kgutwin/teensy-audio-meter/docs/Compact Zoom VU Meter - Display v9.pdf

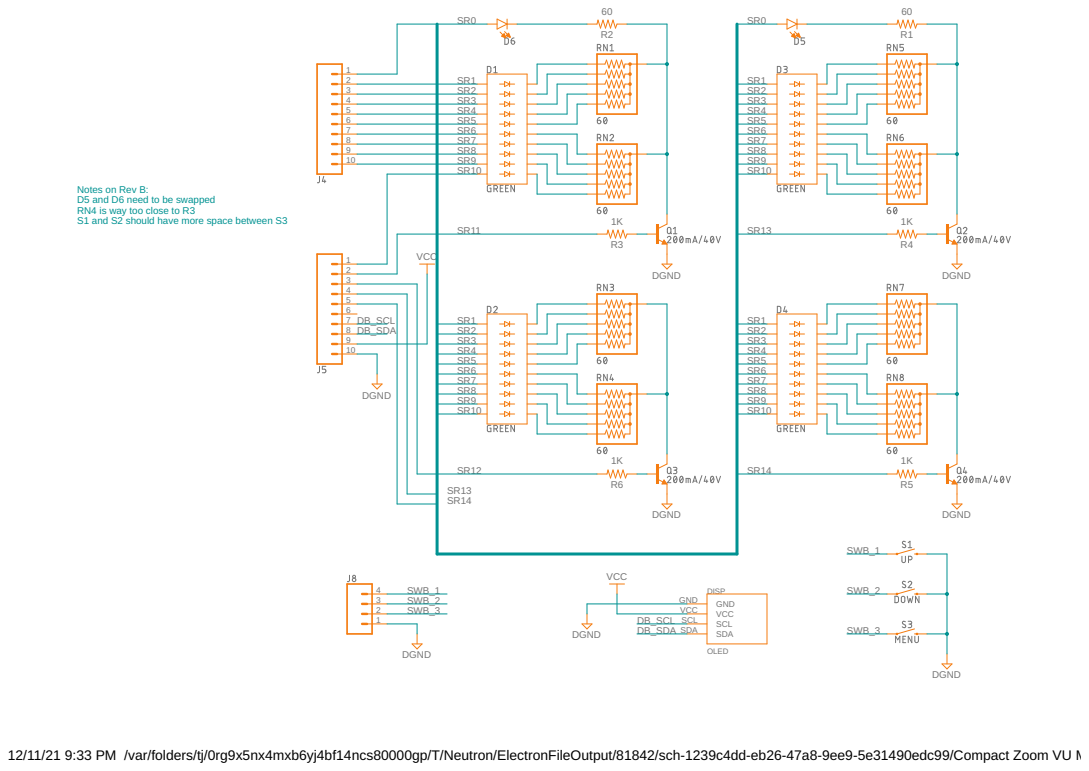
[picture p1: page 1]

Notes on Rev B: D5 and D6 need to be swapped
RN4 is way too close to R3
S1 and S2 should have more space between S3

12/11/21 9:33 PM /var/folders/tj/0rg9x5nx4mxb6yj4bf14ncs80000gp/T/Neutron/ElectronFileOutput/81842/sch-1239c4dd-eb26-47a8-9ee9-5e31490edc99/Compact Zoom VU Meter - Display v9.sch (Sheet: 1/1)
