kgutwin/teensy-audio-meter/docs/Compact Zoom VU Meter - Main v3.pdf

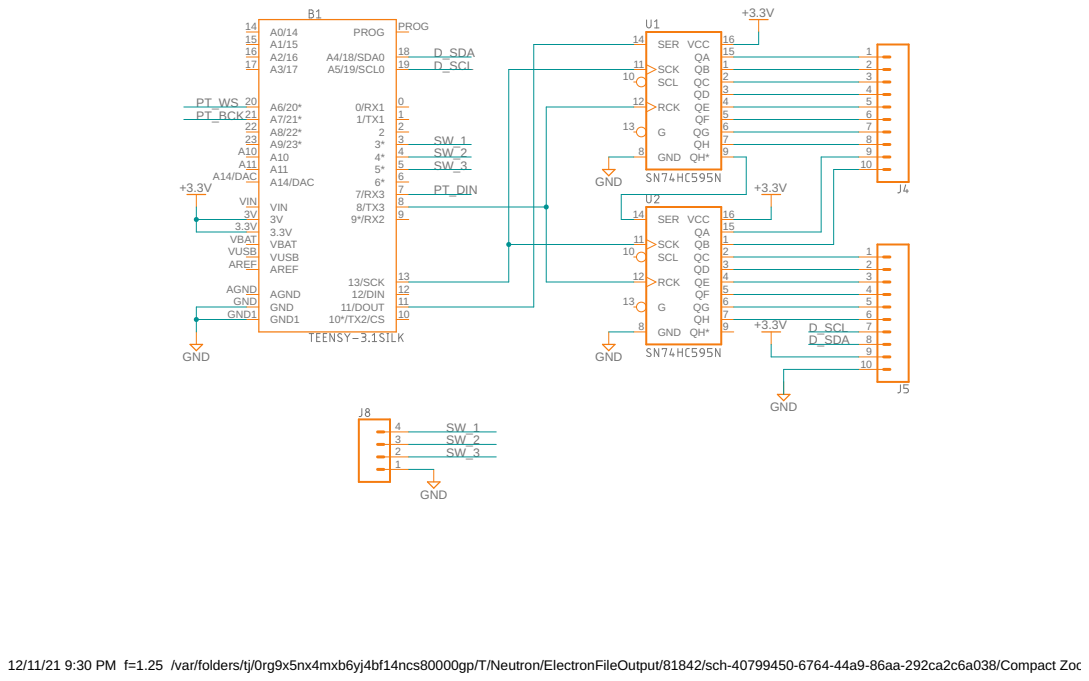
[picture p2: page 1]

12/11/21 9:30 PM f=1.25 /var/folders/tj/0rg9x5nx4mxb6yj4bf14ncs80000gp/T/Neutron/ElectronFileOutput/81842/sch-40799450-6764-44a9-86aa-292ca2c6a038/Compact Zoom VU Meter - Main v3.sch (Sheet: 1/2)

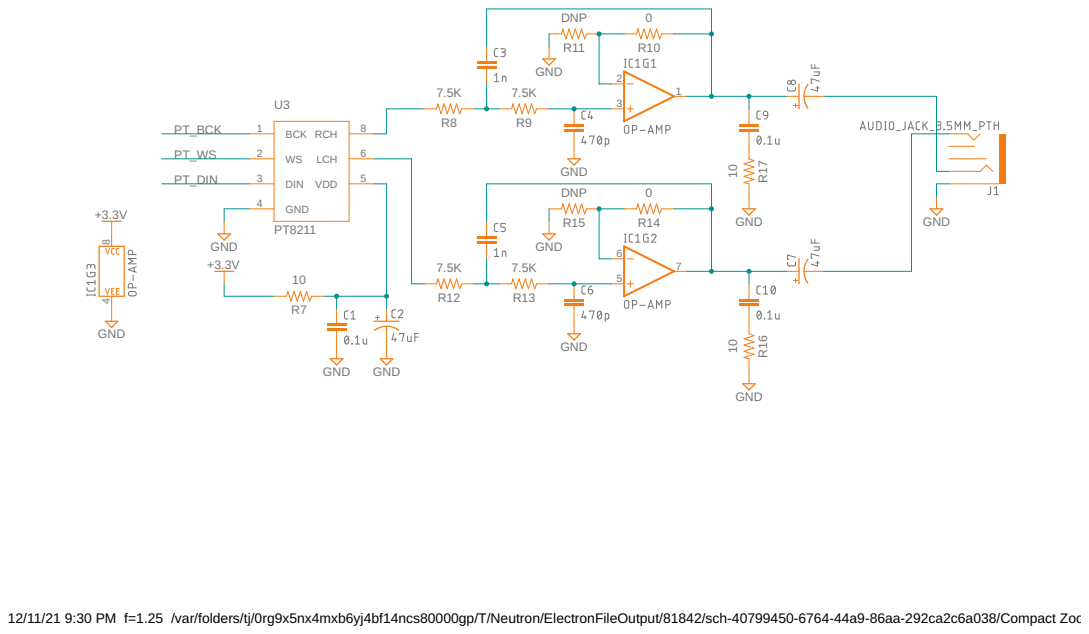
[picture p3: page 2]

12/11/21 9:30 PM f=1.25 /var/folders/tj/0rg9x5nx4mxb6yj4bf14ncs80000gp/T/Neutron/ElectronFileOutput/81842/sch-40799450-6764-44a9-86aa-292ca2c6a038/Compact Zoom VU Meter - Main v3.sch (Sheet: 2/2)
